atmaker/DB2.x-Hardware/PCB/PCB KiCad/PCB KiCad.step

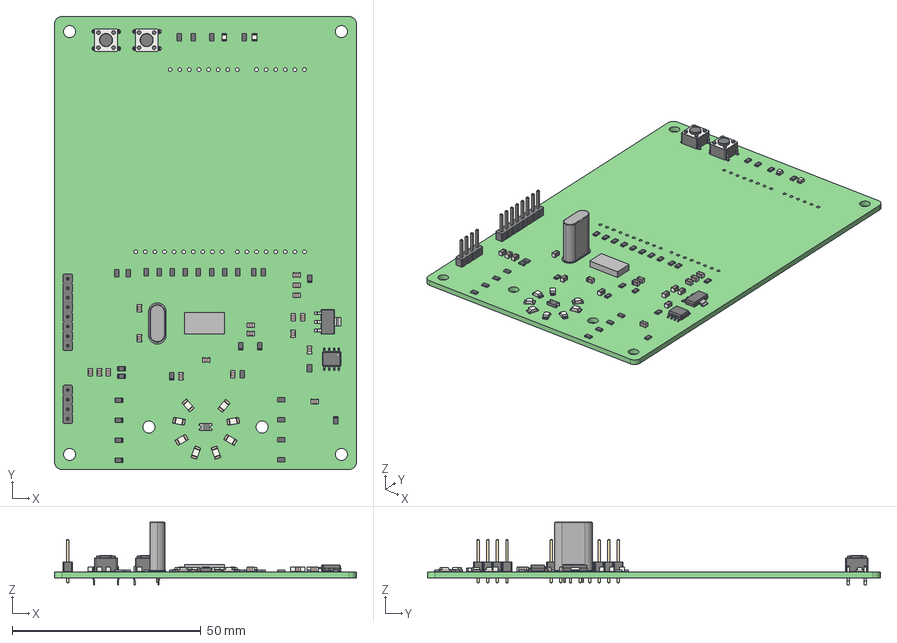
[picture p1: CAD file, 2023-01-23]
PCB/PCB KiCad/PCB KiCad.step
80.0 x 120.0 x 16.6 mm
PCB KiCad PCB
