atmaker/DB2.x-Hardware/PCB/PCB KiCad/adc.kicad_sch

## KiCad design PCB/PCB KiCad/adc.kicad_sch (2023-01-23)

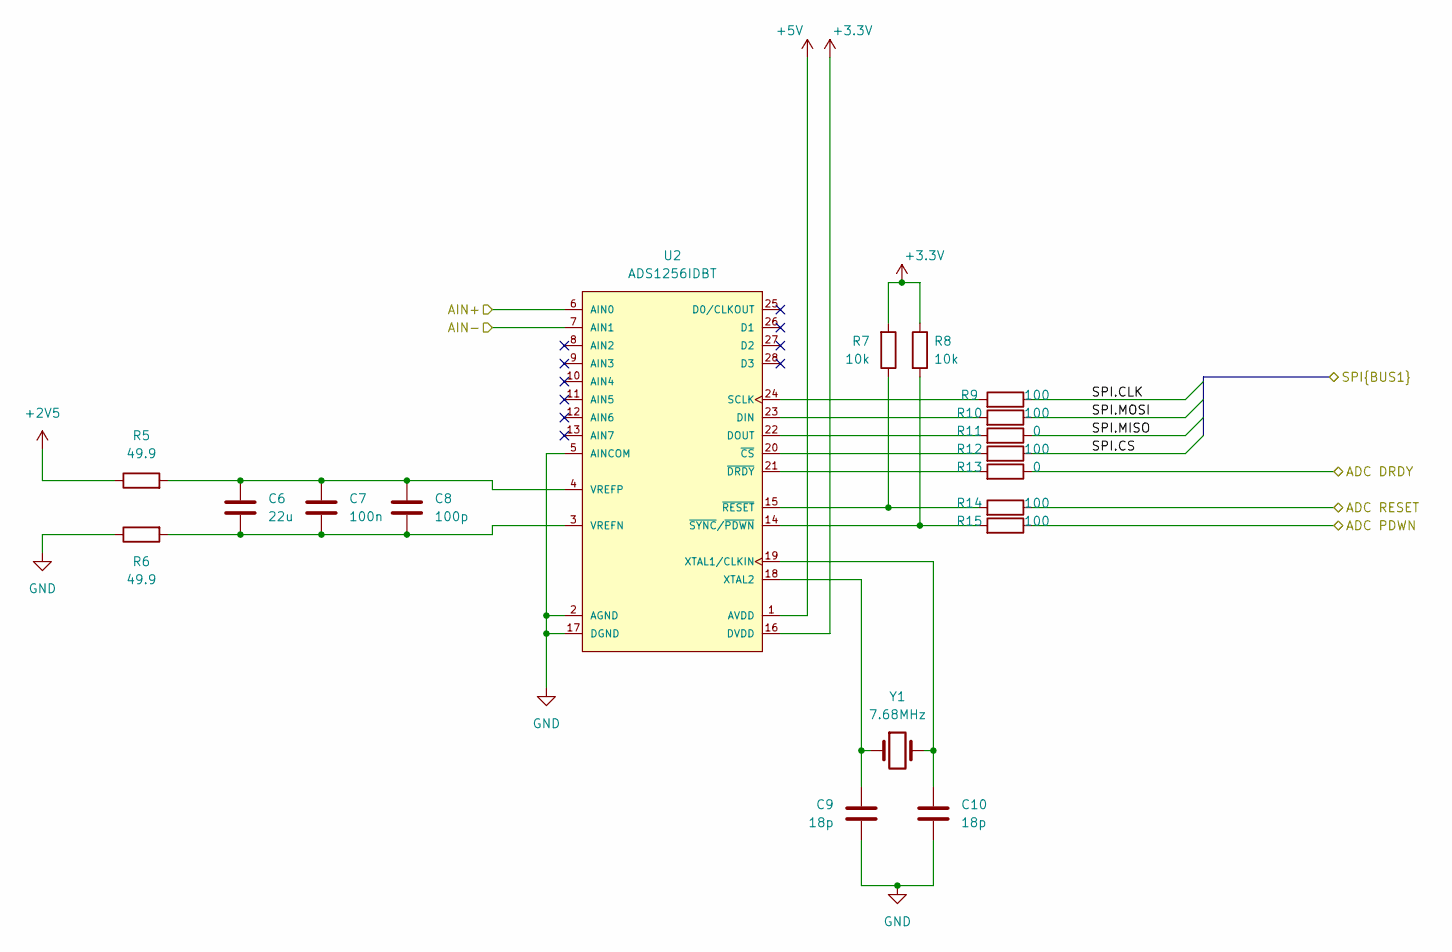
[picture p2: schematic adc.kicad_sch]

Parts:
C6: 22u; C_0805_2012Metric_Pad1.18x1.45mm_HandSolder
C7: 100n; C_0805_2012Metric_Pad1.18x1.45mm_HandSolder
C8: 100p; C_0805_2012Metric_Pad1.18x1.45mm_HandSolder
C9, C10: 18p; C_0805_2012Metric_Pad1.18x1.45mm_HandSolder
R5, R6: 49.9; R_0805_2012Metric_Pad1.20x1.40mm_HandSolder
R7, R8: 10k; R_0805_2012Metric_Pad1.20x1.40mm_HandSolder
R9, R10, R12, R14, R15: 100; R_0805_2012Metric_Pad1.20x1.40mm_HandSolder
R11, R13: 0; R_0805_2012Metric_Pad1.20x1.40mm_HandSolder
U2: ADS1256IDBT; Texas_Instruments-ADS1256IDBT-Level_A; Analog Voltage AVDDMaxV 5.25; Analog Voltage AVDDMinV 4.75; Digital SupplyMaxV 3.6
Y1: 7.68MHz; Crystal_HC49-U_Vertical

Connections:
+2V5: R5.1
+3.3V: R7.2, R8.1, U2.16 (DVDD)
+5V: U2.1 (AVDD)
ADC DRDY: R13.1
ADC PDWN: R15.1
ADC RESET: R14.1
AIN+: U2.6 (AIN0)
AIN-: U2.7 (AIN1)
GND: C9.1, C10.2, R6.1, U2.2 (AGND), U2.5 (AINCOM), U2.17 (DGND)
unnamed: C6.1, C7.1, C8.1, R5.2, U2.4 (VREFP)
unnamed: C6.2, C7.2, C8.2, R6.2, U2.3 (VREFN)
unnamed: C9.2, U2.18 (XTAL2), Y1.1
unnamed: C10.1, U2.19 (XTAL1/CLKIN), Y1.2
unnamed: R9.2, U2.24 (SCLK)
unnamed: R10.2, U2.23 (DIN)
unnamed: R11.2, U2.22 (DOUT)
unnamed: R12.2, U2.20 (~CS)
unnamed: R13.2, U2.21 (~DRDY)
unnamed: R7.1, R14.2, U2.15 (~RESET)
unnamed: R8.2, R15.2, U2.14 (~SYNC/~PDWN)
SPI.CLK: R9.1
SPI.CS: R12.1
SPI.MISO: R11.1
SPI.MOSI: R10.1
