atmaker/DB2.x-Hardware/PCB/PCB KiCad/led.kicad_sch

## KiCad design PCB/PCB KiCad/led.kicad_sch (2023-01-23)

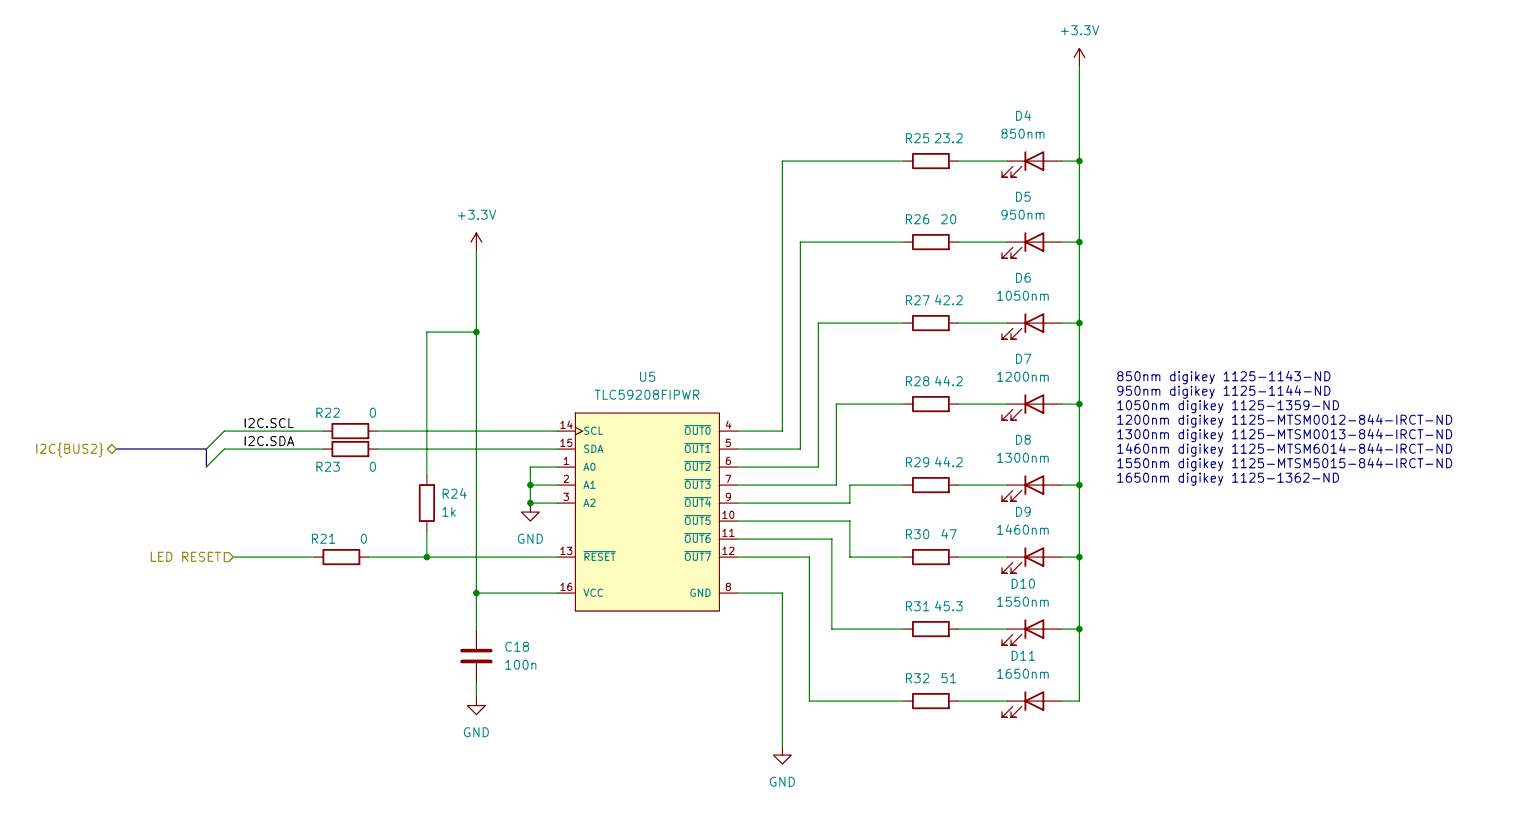
[picture p3: schematic led.kicad_sch]

Parts:
C18: 100n; C_0805_2012Metric_Pad1.18x1.45mm_HandSolder
D4: 850nm; LED_1206_3216Metric_Pad1.42x1.75mm_HandSolder
D5: 950nm; LED_1206_3216Metric_Pad1.42x1.75mm_HandSolder
D6: 1050nm; LED_1206_3216Metric_Pad1.42x1.75mm_HandSolder
D7: 1200nm; LED_1206_3216Metric_Pad1.42x1.75mm_HandSolder
D8: 1300nm; LED_1206_3216Metric_Pad1.42x1.75mm_HandSolder
D9: 1460nm; LED_1206_3216Metric_Pad1.42x1.75mm_HandSolder
D10: 1550nm; LED_1206_3216Metric_Pad1.42x1.75mm_HandSolder
D11: 1650nm; LED_1206_3216Metric_Pad1.42x1.75mm_HandSolder
R21, R22, R23: 0; R_0805_2012Metric_Pad1.20x1.40mm_HandSolder
R24: 1k; R_0805_2012Metric_Pad1.20x1.40mm_HandSolder
R25: 23.2; R_0805_2012Metric_Pad1.20x1.40mm_HandSolder
R26: 20; R_0805_2012Metric_Pad1.20x1.40mm_HandSolder
R27: 42.2; R_0805_2012Metric_Pad1.20x1.40mm_HandSolder
R28, R29: 44.2; R_0805_2012Metric_Pad1.20x1.40mm_HandSolder
R30: 47; R_0805_2012Metric_Pad1.20x1.40mm_HandSolder
R31: 45.3; R_0805_2012Metric_Pad1.20x1.40mm_HandSolder
R32: 51; R_0805_2012Metric_Pad1.20x1.40mm_HandSolder
U5: TLC59208FIPWR; Texas_Instruments-TLC59208FIPWR-Level_A

Connections:
+3.3V: C18.1, D4.2 (A), D5.2 (A), D6.2 (A), D7.2 (A), D8.2 (A), D9.2 (A), D10.2 (A), D11.2 (A), R24.2, U5.16 (VCC)
GND: C18.2, U5.1 (A0), U5.2 (A1), U5.3 (A2), U5.8 (GND)
I2C.SCL: R22.1
I2C.SDA: R23.1
LED RESET: R21.1
unnamed: D4.1 (K), R25.2
unnamed: D5.1 (K), R26.2
unnamed: D6.1 (K), R27.2
unnamed: D7.1 (K), R28.2
unnamed: D8.1 (K), R29.2
unnamed: D9.1 (K), R30.2
unnamed: D10.1 (K), R31.2
unnamed: D11.1 (K), R32.2
unnamed: R21.2, R24.1, U5.13 (~RESET)
unnamed: R22.2, U5.14 (SCL)
unnamed: R23.2, U5.15 (SDA)
unnamed: R25.1, U5.4 (~OUT0)
unnamed: R26.1, U5.5 (~OUT1)
unnamed: R27.1, U5.6 (~OUT2)
unnamed: R28.1, U5.7 (~OUT3)
unnamed: R29.1, U5.9 (~OUT4)
unnamed: R30.1, U5.10 (~OUT5)
unnamed: R31.1, U5.11 (~OUT6)
unnamed: R32.1, U5.12 (~OUT7)

Notes on the sheet:
850nm digikey 1125-1143-ND 950nm digikey 1125-1144-ND 1050nm digikey 1125-1359-ND 1200nm digikey 1125-MTSM0012-844-IRCT-ND 1300nm digikey 1125-MTSM0013-844-IRCT-ND 1460nm digikey 1125-MTSM6014-844-IRCT-ND 1550nm digikey 1125-MTSM5015-844-IRCT-ND 1650nm digikey 1125-1362-ND
