atmaker/DB2.x-Hardware/PCB/PCB KiCad/mcu.kicad_sch

## KiCad design PCB/PCB KiCad/mcu.kicad_sch (2023-01-23)

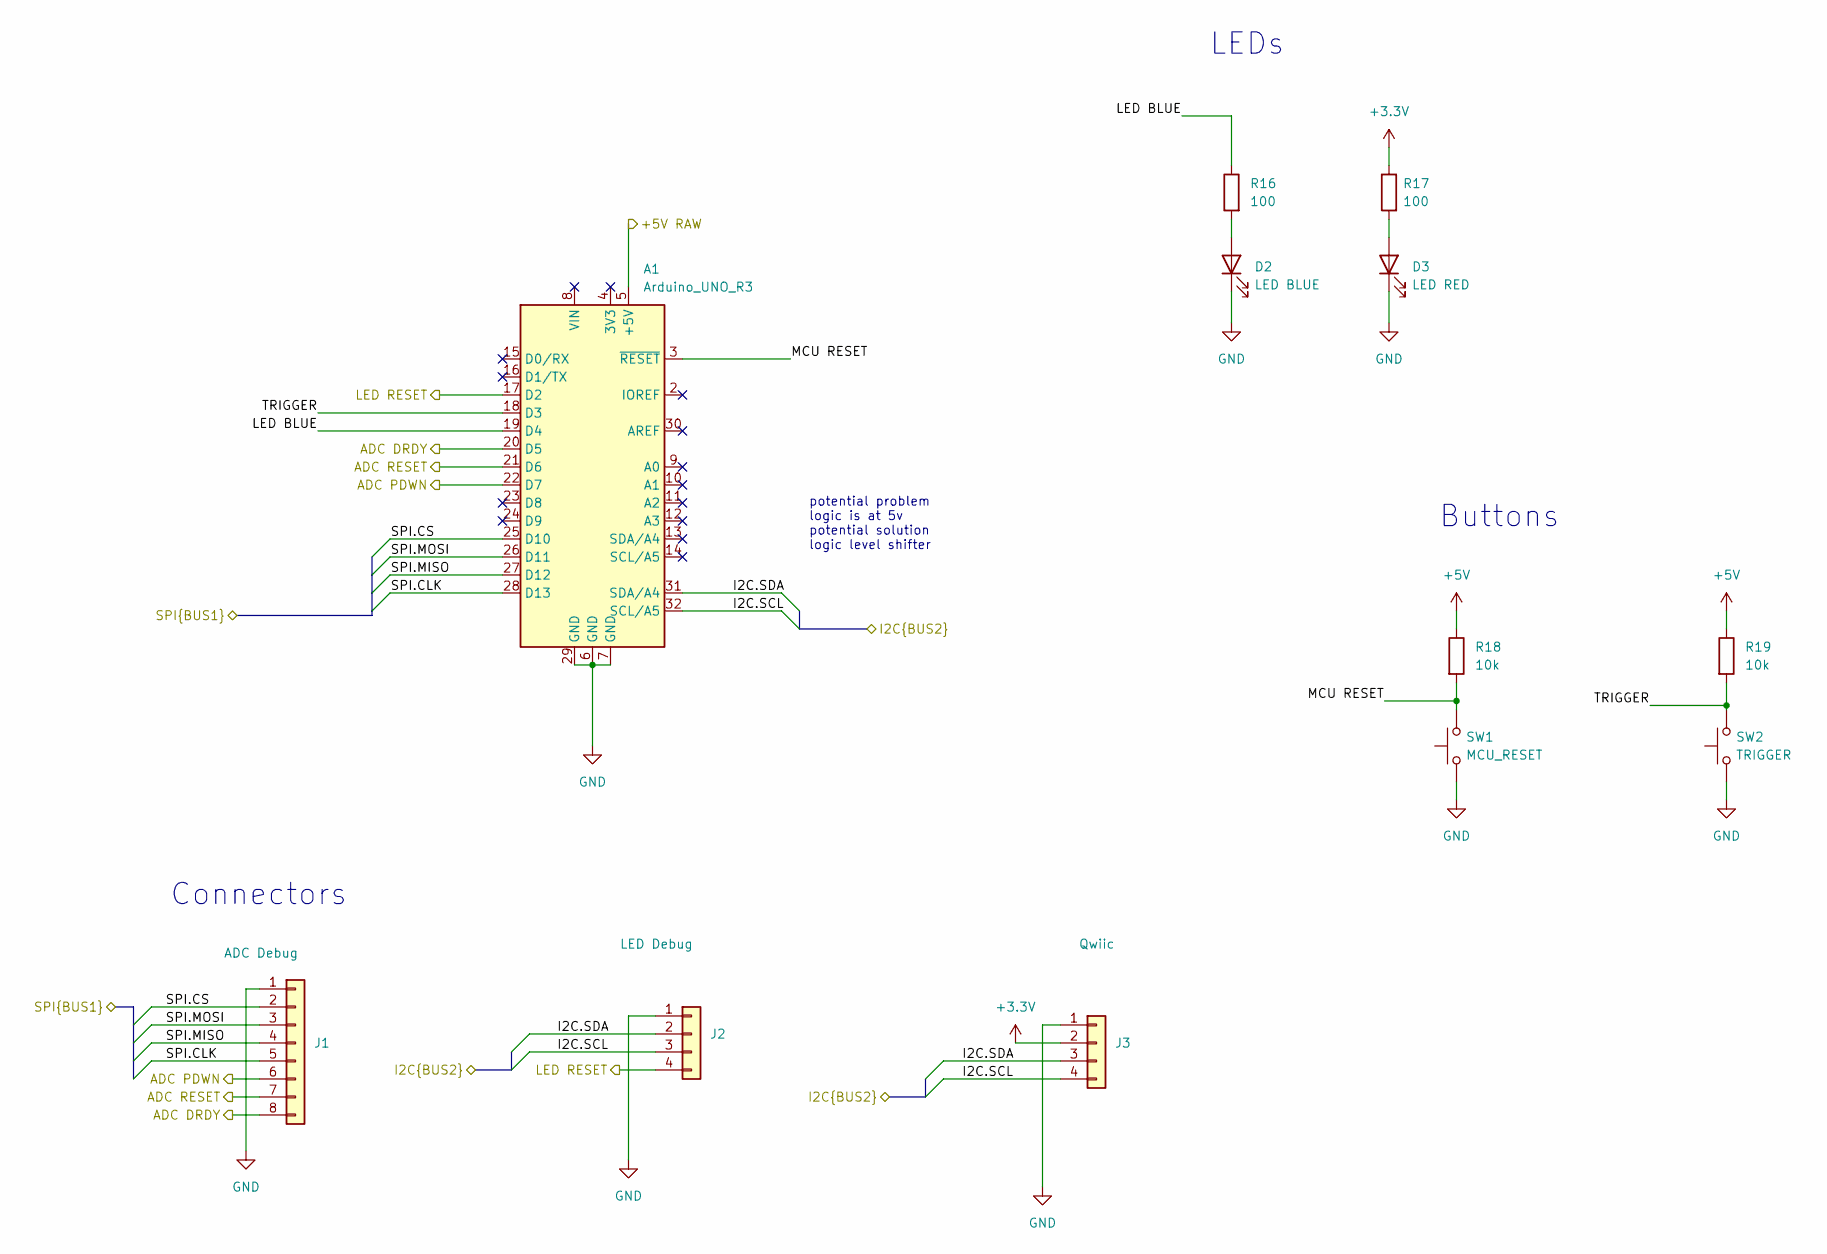
[picture p4: schematic mcu.kicad_sch]

Parts:
A1: Arduino_UNO_R3
D2: LED BLUE; LED_0805_2012Metric_Pad1.15x1.40mm_HandSolder
D3: LED RED; LED_0805_2012Metric_Pad1.15x1.40mm_HandSolder
J1: ADC Debug; PinHeader_1x08_P2.54mm_Vertical
J2: LED Debug; PinHeader_1x04_P2.54mm_Vertical
J3: Qwiic; JST_SH_SM04B-SRSS-TB_1x04-1MP_P1.00mm_Horizontal
R16, R17: 100; R_0805_2012Metric_Pad1.20x1.40mm_HandSolder
R18, R19: 10k; R_0805_2012Metric_Pad1.20x1.40mm_HandSolder
SW1: MCU_RESET; SW_PUSH_6mm
SW2: TRIGGER; SW_PUSH_6mm

Connections:
+3.3V: J3.2, R17.1
+5V: R18.1, R19.1
+5V RAW: A1.5 (+5V)
ADC DRDY: A1.20 (D5), J1.8
ADC PDWN: A1.22 (D7), J1.6
ADC RESET: A1.21 (D6), J1.7
GND: A1.6 (GND), A1.7 (GND), A1.29 (GND), D2.1 (K), D3.1 (K), J1.1, J2.1, J3.1, SW1.1, SW2.1
I2C.SCL: A1.32 (SCL/A5), J2.3, J3.4
I2C.SDA: A1.31 (SDA/A4), J2.2, J3.3
LED BLUE: A1.19 (D4), R16.1
LED RESET: A1.17 (D2), J2.4
MCU RESET: A1.3 (~RESET), R18.2, SW1.2
unnamed: D2.2 (A), R16.2
unnamed: D3.2 (A), R17.2
SPI.CLK: A1.28 (D13), J1.5
SPI.CS: A1.25 (D10), J1.2
SPI.MISO: A1.27 (D12), J1.4
SPI.MOSI: A1.26 (D11), J1.3
TRIGGER: A1.18 (D3), R19.2, SW2.2

Notes on the sheet:
LEDs
potential problem logic is at 5v potential solution logic level shifter
Connectors
Buttons
