atmaker/DB2.x-Hardware/PCB/PCB KiCad/power.kicad_sch

## KiCad design PCB/PCB KiCad/power.kicad_sch (2023-01-23)

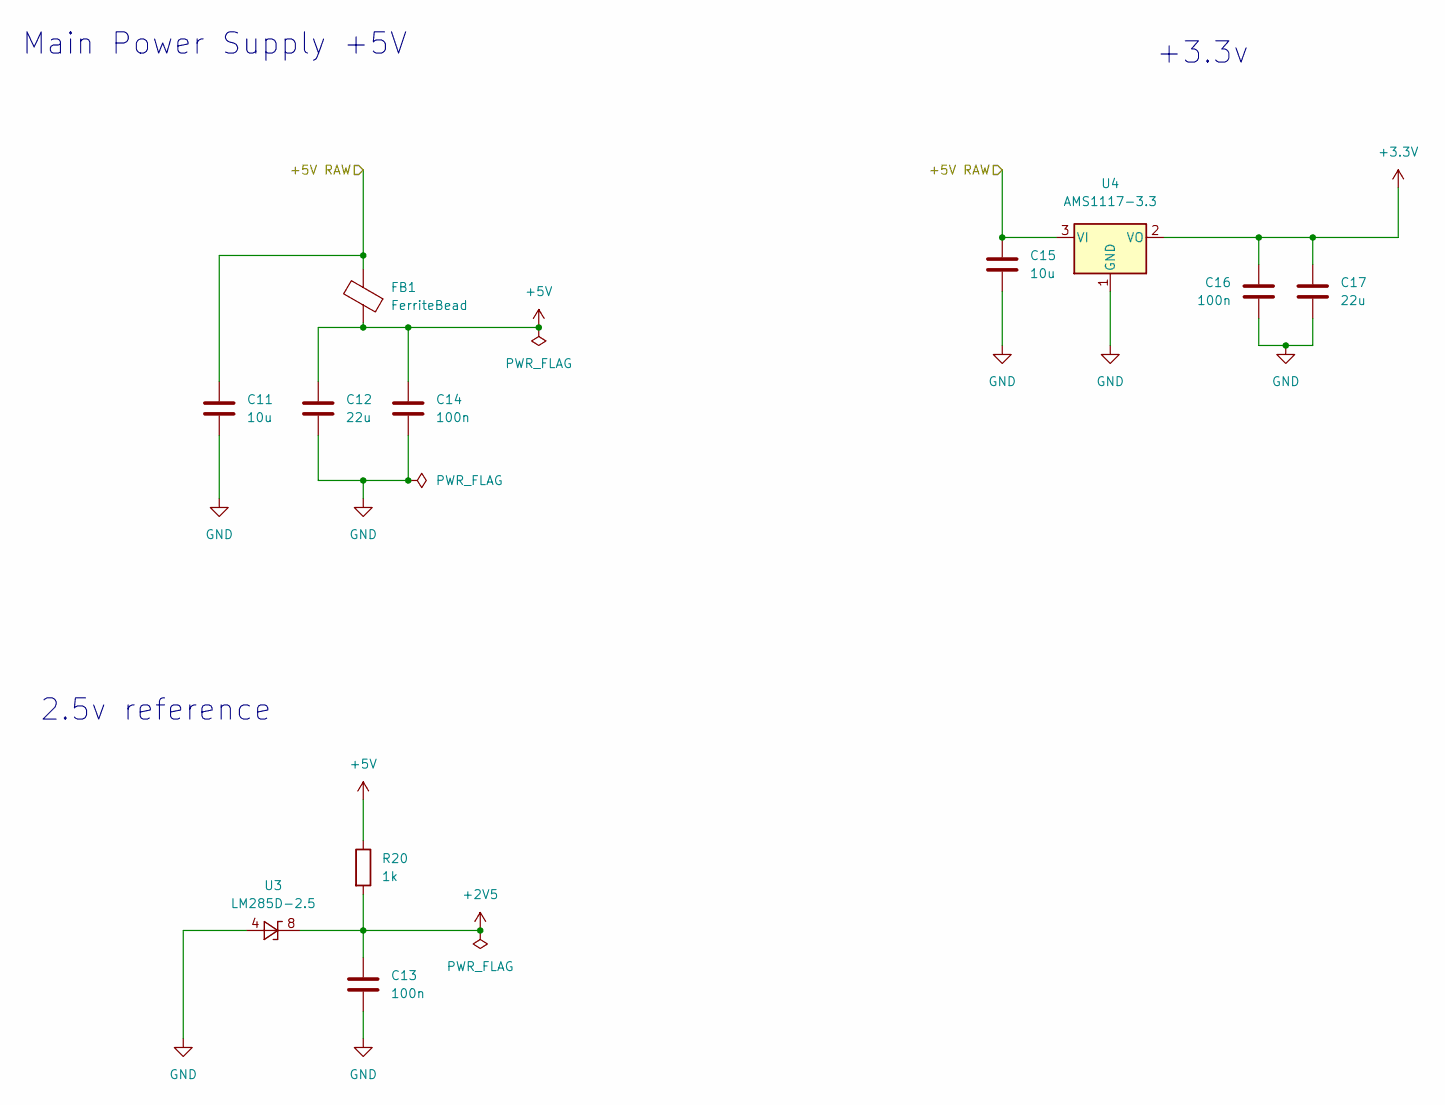
[picture p5: schematic power.kicad_sch]

Parts:
C11, C15: 10u; C_0805_2012Metric_Pad1.18x1.45mm_HandSolder
C12, C17: 22u; C_0805_2012Metric_Pad1.18x1.45mm_HandSolder
C13, C14, C16: 100n; C_0805_2012Metric_Pad1.18x1.45mm_HandSolder
FB1: FerriteBead; R_0805_2012Metric_Pad1.20x1.40mm_HandSolder
R20: 1k; R_0805_2012Metric_Pad1.20x1.40mm_HandSolder
U3: LM285D-2.5; SOIC-8_3.9x4.9mm_P1.27mm
U4: AMS1117-3.3; SOT-223-3_TabPin2

Connections:
+2V5: C13.1, R20.2, U3.8 (K)
+3.3V: C16.2, C17.1, U4.2 (VO)
+5V: C12.1, C14.1, FB1.1, R20.1
+5V RAW: C11.1, C15.1, FB1.2, U4.3 (VI)
GND: C11.2, C12.2, C13.2, C14.2, C15.2, C16.1, C17.2, U3.4 (A), U4.1 (GND)

Notes on the sheet:
Main Power Supply +5V
2.5v reference
+3.3v
