atmaker/DB2.x-Hardware/PCB/PCB KiCad/sensor.kicad_sch

## KiCad design PCB/PCB KiCad/sensor.kicad_sch (2023-01-23)

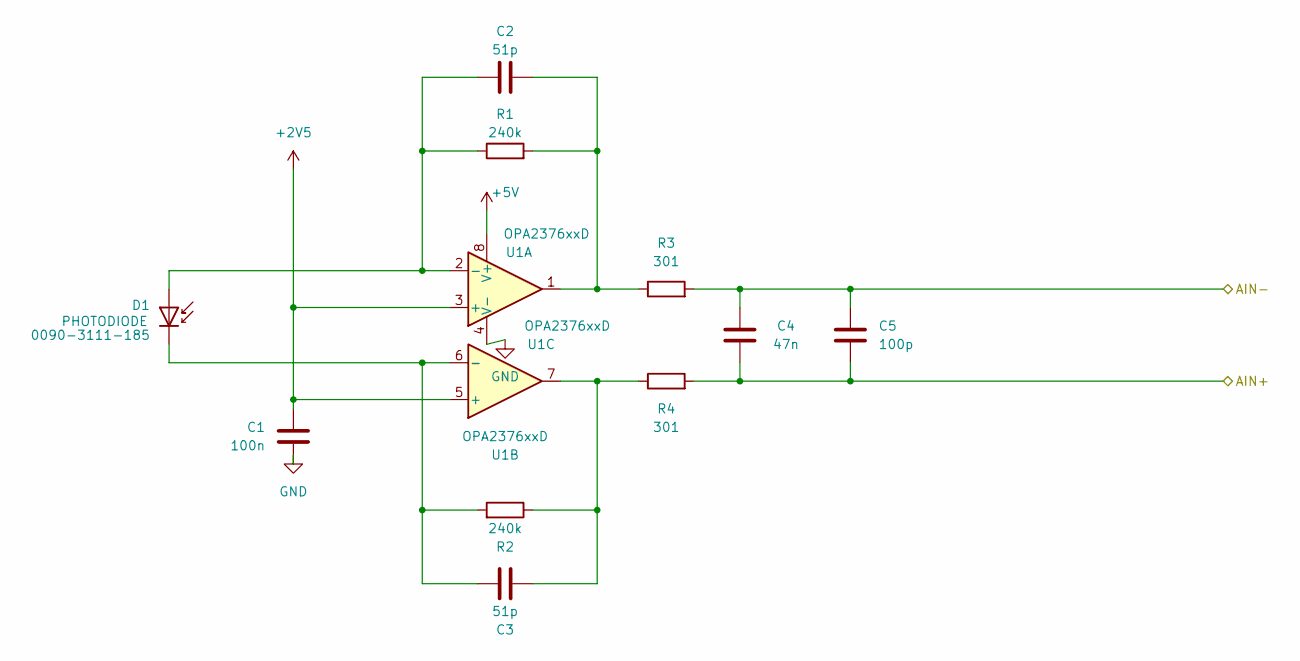
[picture p6: schematic sensor.kicad_sch]

Parts:
C1: 100n; C_0805_2012Metric_Pad1.18x1.45mm_HandSolder
C2, C3: 51p; C_0805_2012Metric_Pad1.18x1.45mm_HandSolder
C4: 47n; C_0805_2012Metric_Pad1.18x1.45mm_HandSolder
C5: 100p; C_0805_2012Metric_Pad1.18x1.45mm_HandSolder
D1: 0090-3111-185; D_1206_3216Metric_Pad1.42x1.75mm_HandSolder
R1, R2: 240k; R_0805_2012Metric_Pad1.20x1.40mm_HandSolder
R3, R4: 301; R_0805_2012Metric_Pad1.20x1.40mm_HandSolder
U1: OPA2376xxD; Texas_Instruments-OPA2376AID-Level_A

Connections:
+2V5: C1.2, U1.3 (+), U1.5 (+)
+5V: U1.8 (V+)
AIN+: C4.1, C5.2, R4.2
AIN-: C4.2, C5.1, R3.2
GND: C1.1, U1.4 (V-)
unnamed: C2.1, D1.2 (A), R1.1, U1.2 (-)
unnamed: C2.2, R1.2, R3.1, U1.1
unnamed: C3.1, D1.1 (K), R2.2, U1.6 (-)
unnamed: C3.2, R2.1, R4.1, U1.7
